Chainsawfelix/ELEC3117-BLUESAT/MAIN.kicad_pcb

## KiCad design MAIN.kicad_pcb (2026-08-09)

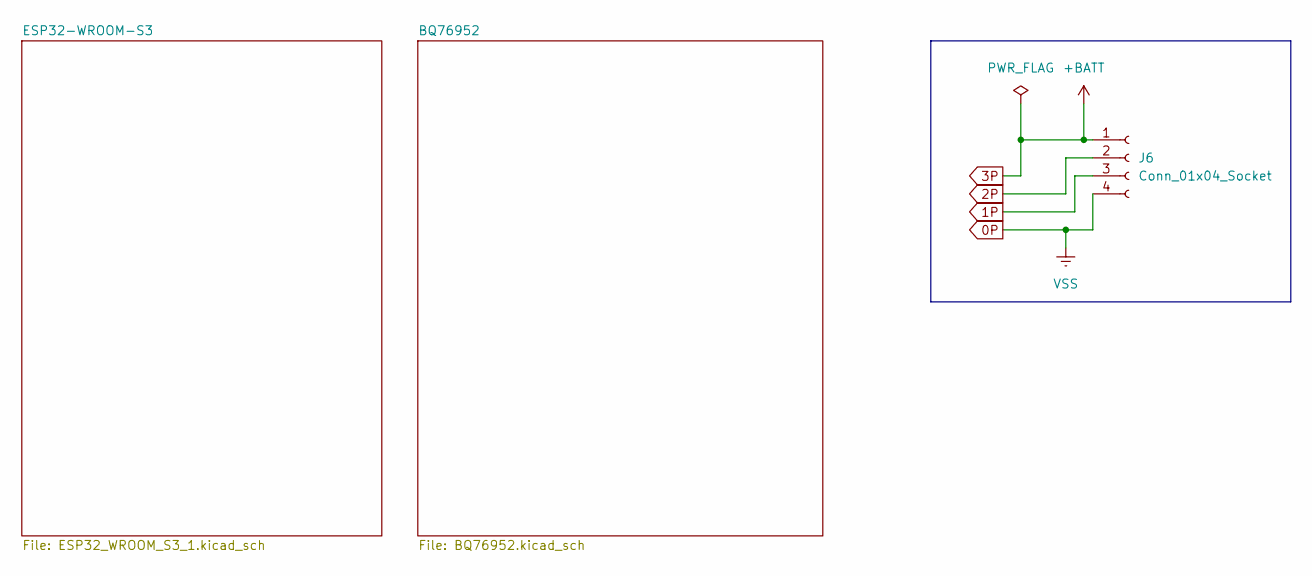
[picture p1: schematic MAIN.kicad_sch]

Parts:
J6: Conn_01x04_Socket; JST_XH_B4B-XH-A_1x04_P2.50mm_Vertical

Connections:
0P: J6.4; also elsewhere on the board
1P: J6.3; also elsewhere on the board
2P: J6.2; also elsewhere on the board

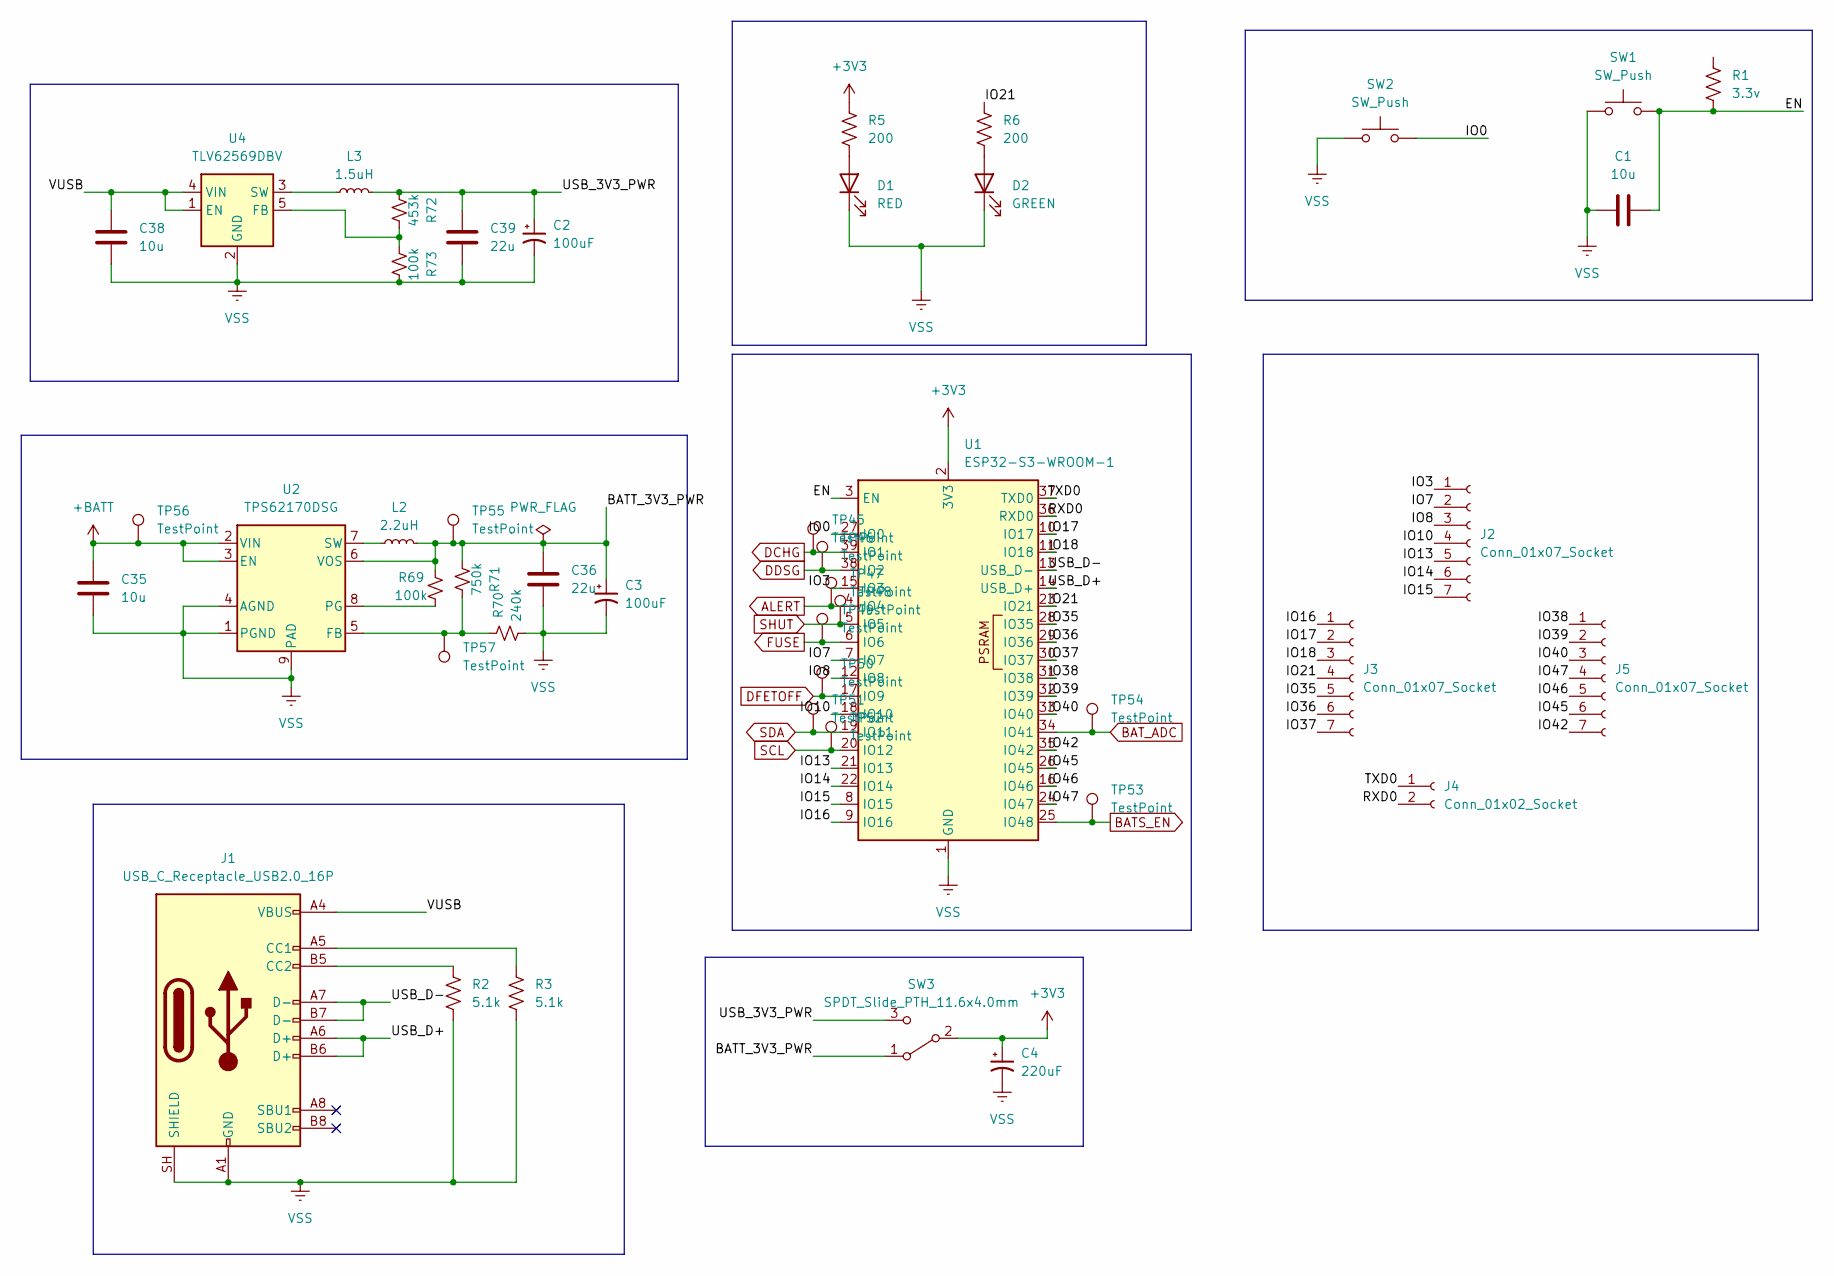
[picture p2: schematic ESP32_WROOM_S3_1.kicad_sch]

Parts:
C1, C35, C38: 10u; C_0805_2012Metric
C2, C3: 100uF; CP_Elec_6.3x5.8
C4: 220uF; CP_Elec_6.3x5.8
C36, C39: 22u; C_0805_2012Metric
D1: RED; LED_0805_2012Metric
D2: GREEN; LED_0805_2012Metric
J1: USB_C_Receptacle_USB2.0_16P; USB_C_Receptacle_GCT_USB4105-xx-A_16P_TopMnt_Horizontal
J2, J3, J5: Conn_01x07_Socket; JST_XH_B7B-XH-A_1x07_P2.50mm_Vertical
J4: Conn_01x02_Socket; JST_XH_B2B-XH-A_1x02_P2.50mm_Vertical
L2: 2.2uH; L_Wuerth_MAPI-3020
L3: 1.5uH; L_Wuerth_MAPI-3020
R1: 3.3v; R_0805_2012Metric
R2, R3: 5.1k; R_0805_2012Metric
R5, R6: 200; R_0805_2012Metric
R69, R73: 100k; R_0805_2012Metric
R70: 240k; R_0805_2012Metric
R71: 750k; R_0805_2012Metric
R72: 453k; R_0805_2012Metric
SW1, SW2: SW_Push; Push_SMD_4.2x3.2mm
SW3: SPDT_Slide_PTH_11.6x4.0mm; Slide_SPDT_PTH_11.6x4.0mm
TP45, TP46, TP47, TP48, TP49, TP50, TP51, TP52, TP53, TP54, TP55, TP56, TP57: TestPoint; TestPoint_Pad_D1.0mm
U1: ESP32-S3-WROOM-1
U2: TPS62170DSG; WSON-8-1EP_2x2mm_P0.5mm_EP0.9x1.6mm_ThermalVias
U4: TLV62569DBV; SOT-23-5

Connections:
0P: C1.1, C2.2, C3.2, C4.2, C35.2, C36.2, C38.2, C39.2, D1.1 (K), D2.1 (K), J1.A1 (GND), J1.A12 (GND), J1.B1 (GND), J1.B12 (GND), J1.SH (SHIELD), R2.2, R3.2, R70.2, R73.2, SW1.1, SW2.1, U1.1 (GND), U1.40 (GND), U1.41 (GND), U2.1 (PGND), U2.4 (AGND), U2.9 (PAD), U4.2 (GND); also elsewhere on the board
+3V3: C4.1, R5.1, SW3.2 (B), U1.2 (3V3); also elsewhere on the board
/ESP32-WROOM-S3/BATT_3V3_PWR: C3.1, C36.1, L2.2, R69.1, R71.1, SW3.1 (A), TP55.1 (1_1), U2.6 (VOS)
/ESP32-WROOM-S3/IO0: SW2.2, U1.27 (IO0)
/ESP32-WROOM-S3/IO3: J2.1, U1.15 (IO3)
/ESP32-WROOM-S3/IO7: J2.2, U1.7 (IO7)
/ESP32-WROOM-S3/IO8: J2.3, U1.12 (IO8)
/ESP32-WROOM-S3/IO10: J2.4, U1.18 (IO10)
/ESP32-WROOM-S3/IO13: J2.5, U1.21 (IO13)
/ESP32-WROOM-S3/IO14: J2.6, U1.22 (IO14)
/ESP32-WROOM-S3/IO15: J2.7, U1.8 (IO15)
/ESP32-WROOM-S3/IO16: J3.1, U1.9 (IO16)
/ESP32-WROOM-S3/IO17: J3.2, U1.10 (IO17)
/ESP32-WROOM-S3/IO18: J3.3, U1.11 (IO18)
/ESP32-WROOM-S3/IO21: J3.4, R6.1, U1.23 (IO21)
/ESP32-WROOM-S3/IO35: J3.5, U1.28 (IO35)
/ESP32-WROOM-S3/IO36: J3.6, U1.29 (IO36)
/ESP32-WROOM-S3/IO37: J3.7, U1.30 (IO37)
/ESP32-WROOM-S3/IO38: J5.1, U1.31 (IO38)
/ESP32-WROOM-S3/IO39: J5.2, U1.32 (IO39)
/ESP32-WROOM-S3/IO40: J5.3, U1.33 (IO40)
/ESP32-WROOM-S3/IO42: J5.7, U1.35 (IO42)
/ESP32-WROOM-S3/IO45: J5.6, U1.26 (IO45)
/ESP32-WROOM-S3/IO46: J5.5, U1.16 (IO46)
/ESP32-WROOM-S3/IO47: J5.4, U1.24 (IO47)
/ESP32-WROOM-S3/RXD0: J4.2, U1.36 (RXD0)
/ESP32-WROOM-S3/TXD0: J4.1, U1.37 (TXD0)
/ESP32-WROOM-S3/USB_3V3_PWR: C2.1, C39.1, L3.2, R72.1, SW3.3 (C)
/ESP32-WROOM-S3/USB_D+: J1.A6 (D+), J1.B6 (D+), U1.14 (USB_D+)
/ESP32-WROOM-S3/USB_D-: J1.A7 (D-), J1.B7 (D-), U1.13 (USB_D-)
/ESP32-WROOM-S3/VUSB: C38.1, J1.A4 (VBUS), J1.A9 (VBUS), J1.B4 (VBUS), J1.B9 (VBUS), U4.1 (EN), U4.4 (VIN)
ALERT: TP47.1, U1.4 (IO4); also elsewhere on the board
BATS_EN: TP53.1 (1_1), U1.25 (IO48); also elsewhere on the board
BAT_ADC: TP54.1 (1_1), U1.34 (IO41); also elsewhere on the board
DCHG: TP45.1, U1.39 (IO1); also elsewhere on the board
DDSG: TP46.1, U1.38 (IO2); also elsewhere on the board
DFETOFF: TP50.1, U1.17 (IO9); also elsewhere on the board
FUSE: TP49.1 (1_1), U1.6 (IO6); also elsewhere on the board
unnamed: D1.2 (A), R5.2
unnamed: D2.2 (A), R6.2
unnamed: J1.A5 (CC1), R3.1
unnamed: J1.B5 (CC2), R2.1
unnamed: R70.1, R71.2, TP57.1 (1_1), U2.5 (FB)
unnamed: R69.2, U2.8 (PG)
unnamed: L2.1, U2.7 (SW)
unnamed: R72.2, R73.1, U4.5 (FB)
unnamed: L3.1, U4.3 (SW)
SCL: TP52.1, U1.20 (IO12); also elsewhere on the board
SDA: TP51.1 (1_1), U1.19 (IO11); also elsewhere on the board
SHUT: TP48.1 (1_1), U1.5 (IO5); also elsewhere on the board

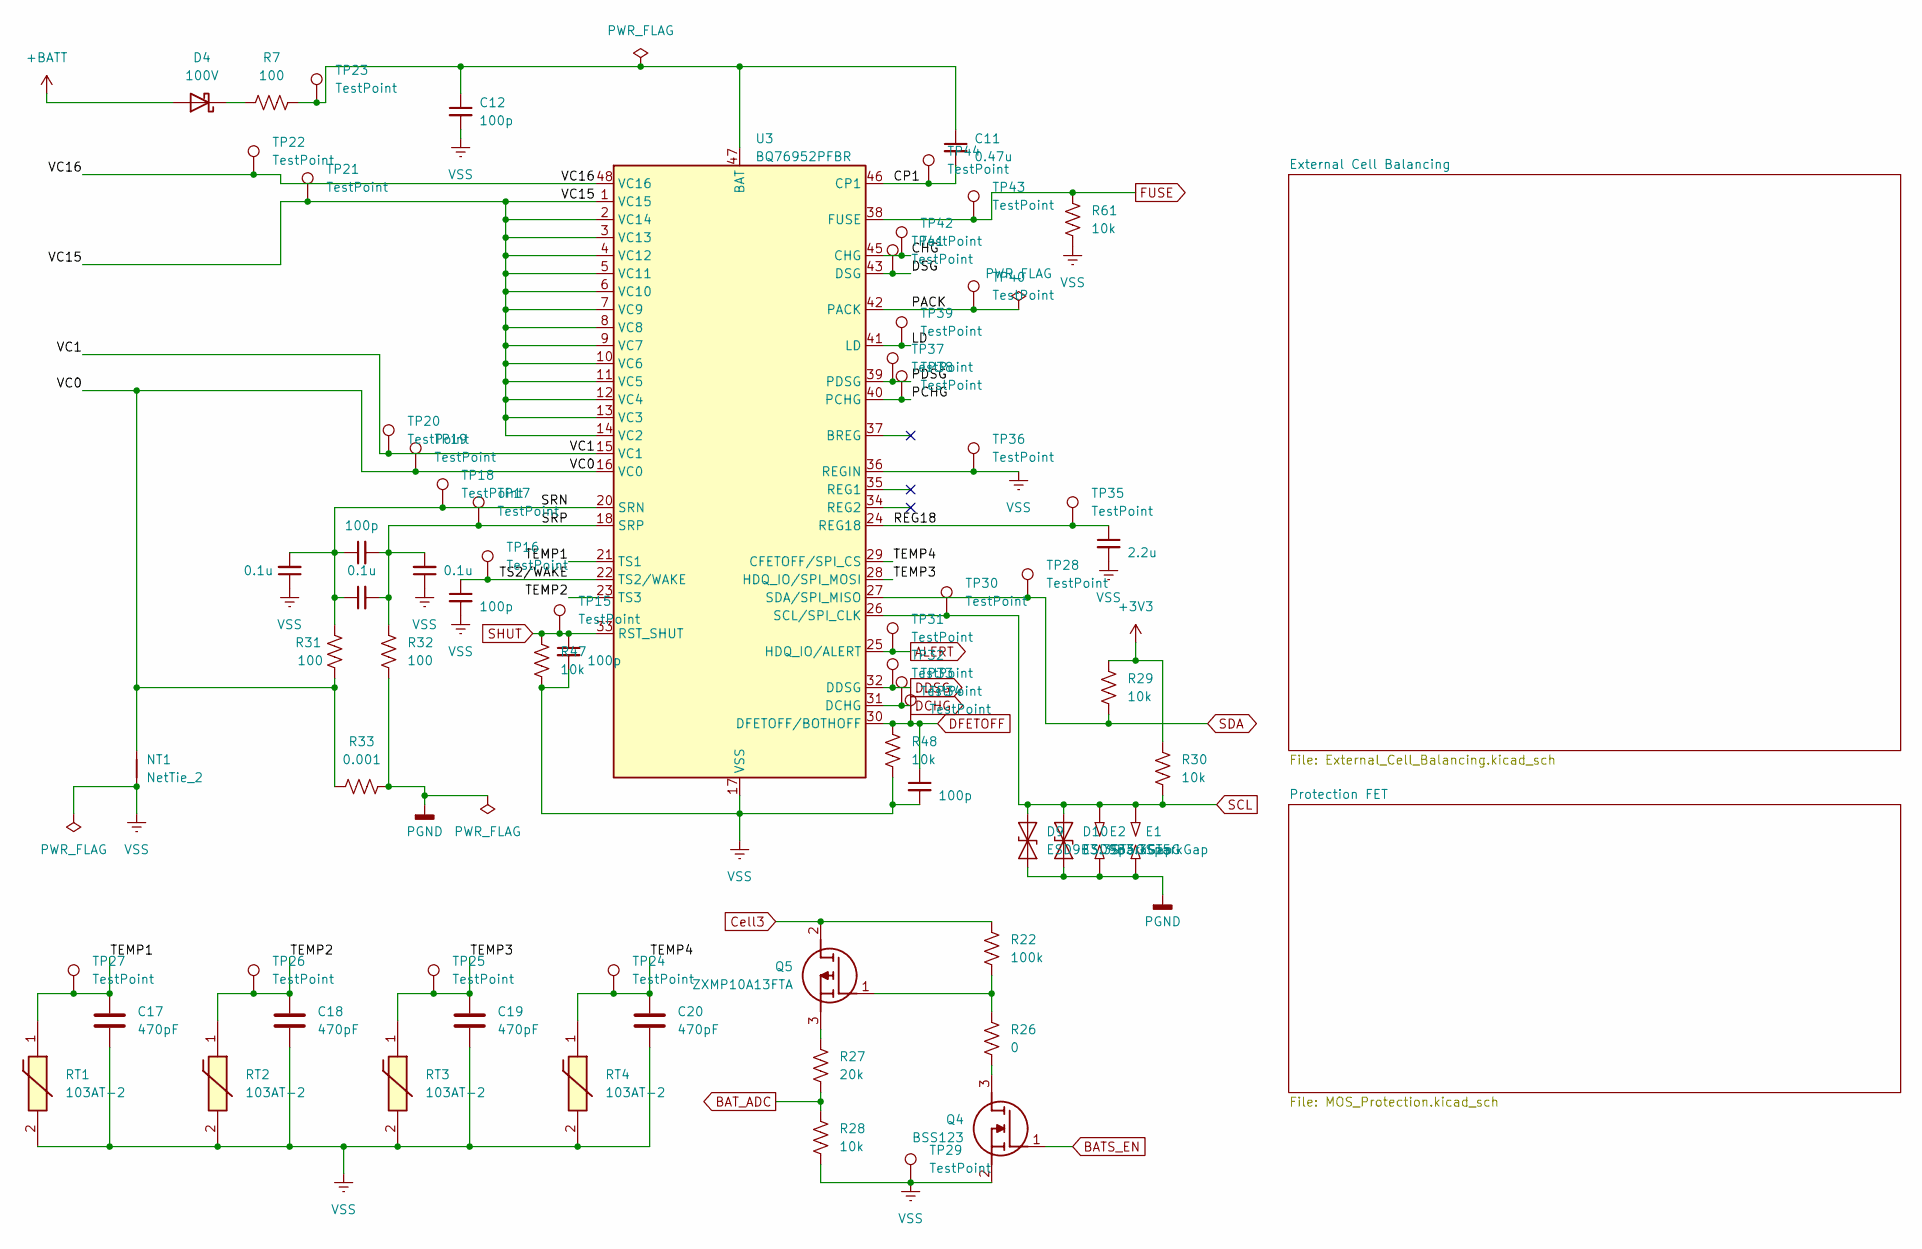
[picture p3: schematic BQ76952.kicad_sch]

Parts:
C11: 0.47u; C_0805_2012Metric
C12, C22, C30, C31, C32: 100p; C_0805_2012Metric
C17, C18, C19, C20: 470pF; C_0805_2012Metric
C21: 2.2u; C_0805_2012Metric
C23, C24, C25: 0.1u; C_0805_2012Metric
D4: 100V; D_0805_2012Metric
D9, D10: ESD9B3.3ST5G; D_SOD-923
E1, E2: SparkGap; SolderJumper-2_P1.3mm_Open_TrianglePad1.0x1.5mm
NT1: NetTie_2; SolderJumper-2_P1.3mm_Bridged2Bar_Pad1.0x1.5mm
Q4: BSS123; SOT96P237X111-3N; Mouser Part Number 512-BSS123
Q5: ZXMP10A13FTA; SOT96P240X110-3N; Mouser Part Number 522-ZXMP10A13FTA
R7, R31, R32: 100; R_0805_2012Metric
R22: 100k; R_0805_2012Metric
R26: 0; R_0805_2012Metric
R27: 20k; R_0805_2012Metric
R28, R29, R30, R47, R48, R61: 10k; R_0805_2012Metric
R33: 0.001; R_2512_6332Metric
RT1, RT2, RT3, RT4: 103AT-2; 103AT2; Mouser Part Number 954-103AT-2
TP15, TP16, TP17, TP18, TP19, TP20, TP21, TP22, TP23, TP24, TP25, TP26, TP27, TP28, TP29, TP30, TP31, TP32, TP33, TP34, TP35, TP36, TP37, TP38, TP39, TP40, TP41, TP42, TP43, TP44: TestPoint; TestPoint_Pad_D1.0mm
U3: BQ76952PFBR; TQFP-48_7x7mm_P0.5mm

Connections:
0P: C12.2, C17.2, C18.2, C19.2, C20.2, C21.2, C24.1, C25.1, C30.2, C31.2, C32.2, NT1.1, Q4.2 (S), R28.2, R47.2, R48.2, R61.2, RT1.2, RT2.2, RT3.2, RT4.2, TP29.1 (1_1), TP36.1 (1_1), U3.17 (VSS), U3.36 (REGIN); also elsewhere on the board
+3V3: R29.1, R30.1; also elsewhere on the board
/BQ76952/CHG: TP42.1 (1_1), U3.45 (CHG)
/BQ76952/CP1: C11.2, TP44.1 (1_1), U3.46 (CP1)
/BQ76952/DSG: TP41.1 (1_1), U3.43 (DSG)
/BQ76952/LD: TP39.1 (1_1), U3.41 (LD)
/BQ76952/PACK: TP40.1 (1_1), U3.42 (PACK)
/BQ76952/PCHG: TP38.1 (1_1), U3.40 (PCHG)
/BQ76952/PDSG: TP37.1 (1_1), U3.39 (PDSG)
/BQ76952/REG18: C21.1, TP35.1 (1_1), U3.24 (REG18)
/BQ76952/SRN: C22.1, C23.1, C24.2, R31.1, TP18.1 (1_1), U3.20 (SRN)
/BQ76952/SRP: C22.2, C23.2, C25.2, R32.1, TP17.1 (1_1), U3.18 (SRP)
/BQ76952/TEMP1: C17.1, RT1.1, TP27.1 (1_1), U3.21 (TS1)
/BQ76952/TEMP2: C18.1, RT2.1, TP26.1 (1_1), U3.23 (TS3)
/BQ76952/TEMP3: C19.1, RT3.1, TP25.1 (1_1), U3.28 (HDQ_IO/SPI_MOSI)
/BQ76952/TEMP4: C20.1, RT4.1, TP24.1 (1_1), U3.29 (CFETOFF/SPI_CS)
/BQ76952/TS2/WAKE: C30.1, TP16.1 (1_1), U3.22 (TS2/WAKE)
/BQ76952/VC0: NT1.2, R31.2, R33.1, TP19.1 (1_1), U3.16 (VC0); also elsewhere on the board
/BQ76952/VC1: TP20.1 (1_1), U3.15 (VC1); also elsewhere on the board
/BQ76952/VC15: TP21.1 (1_1), U3.1 (VC15), U3.2 (VC14), U3.3 (VC13), U3.4 (VC12), U3.5 (VC11), U3.6 (VC10), U3.7 (VC9), U3.8 (VC8), U3.9 (VC7), U3.10 (VC6), U3.11 (VC5), U3.12 (VC4), U3.13 (VC3), U3.14 (VC2); also elsewhere on the board
ALERT: TP31.1 (1_1), U3.25 (HDQ_IO/ALERT); also elsewhere on the board
BATS_EN: Q4.1 (G); also elsewhere on the board
BAT_ADC: R27.2, R28.1; also elsewhere on the board
Cell3: Q5.2 (D), R22.1
DCHG: TP33.1 (1_1), U3.31 (DCHG); also elsewhere on the board
DDSG: TP32.1 (1_1), U3.32 (DDSG); also elsewhere on the board
DFETOFF: C32.1, R48.1, TP34.1 (1_1), U3.30 (DFETOFF/BOTHOFF); also elsewhere on the board
FUSE: R61.1, TP43.1 (1_1), U3.38 (FUSE); also elsewhere on the board
unnamed: D4.1 (K), R7.1
unnamed: Q4.3 (D), R26.2
unnamed: Q5.1 (G), R22.2, R26.1
unnamed: Q5.3 (S), R27.1
unnamed 109: C11.1, C12.1, R7.2, TP23.1 (1_1), U3.47 (BAT); also elsewhere on the board
PACK-: D9.1 (A1), D10.1 (A1), E1.1, E2.1, R32.2, R33.2; also elsewhere on the board
SCL: D9.2 (A2), D10.2 (A2), E1.2, E2.2, R30.2, TP30.1 (1_1), U3.26 (SCL/SPI_CLK); also elsewhere on the board
SDA: R29.2, TP28.1 (1_1), U3.27 (SDA/SPI_MISO); also elsewhere on the board
SHUT: C31.1, R47.1, TP15.1 (1_1), U3.33 (RST_SHUT); also elsewhere on the board

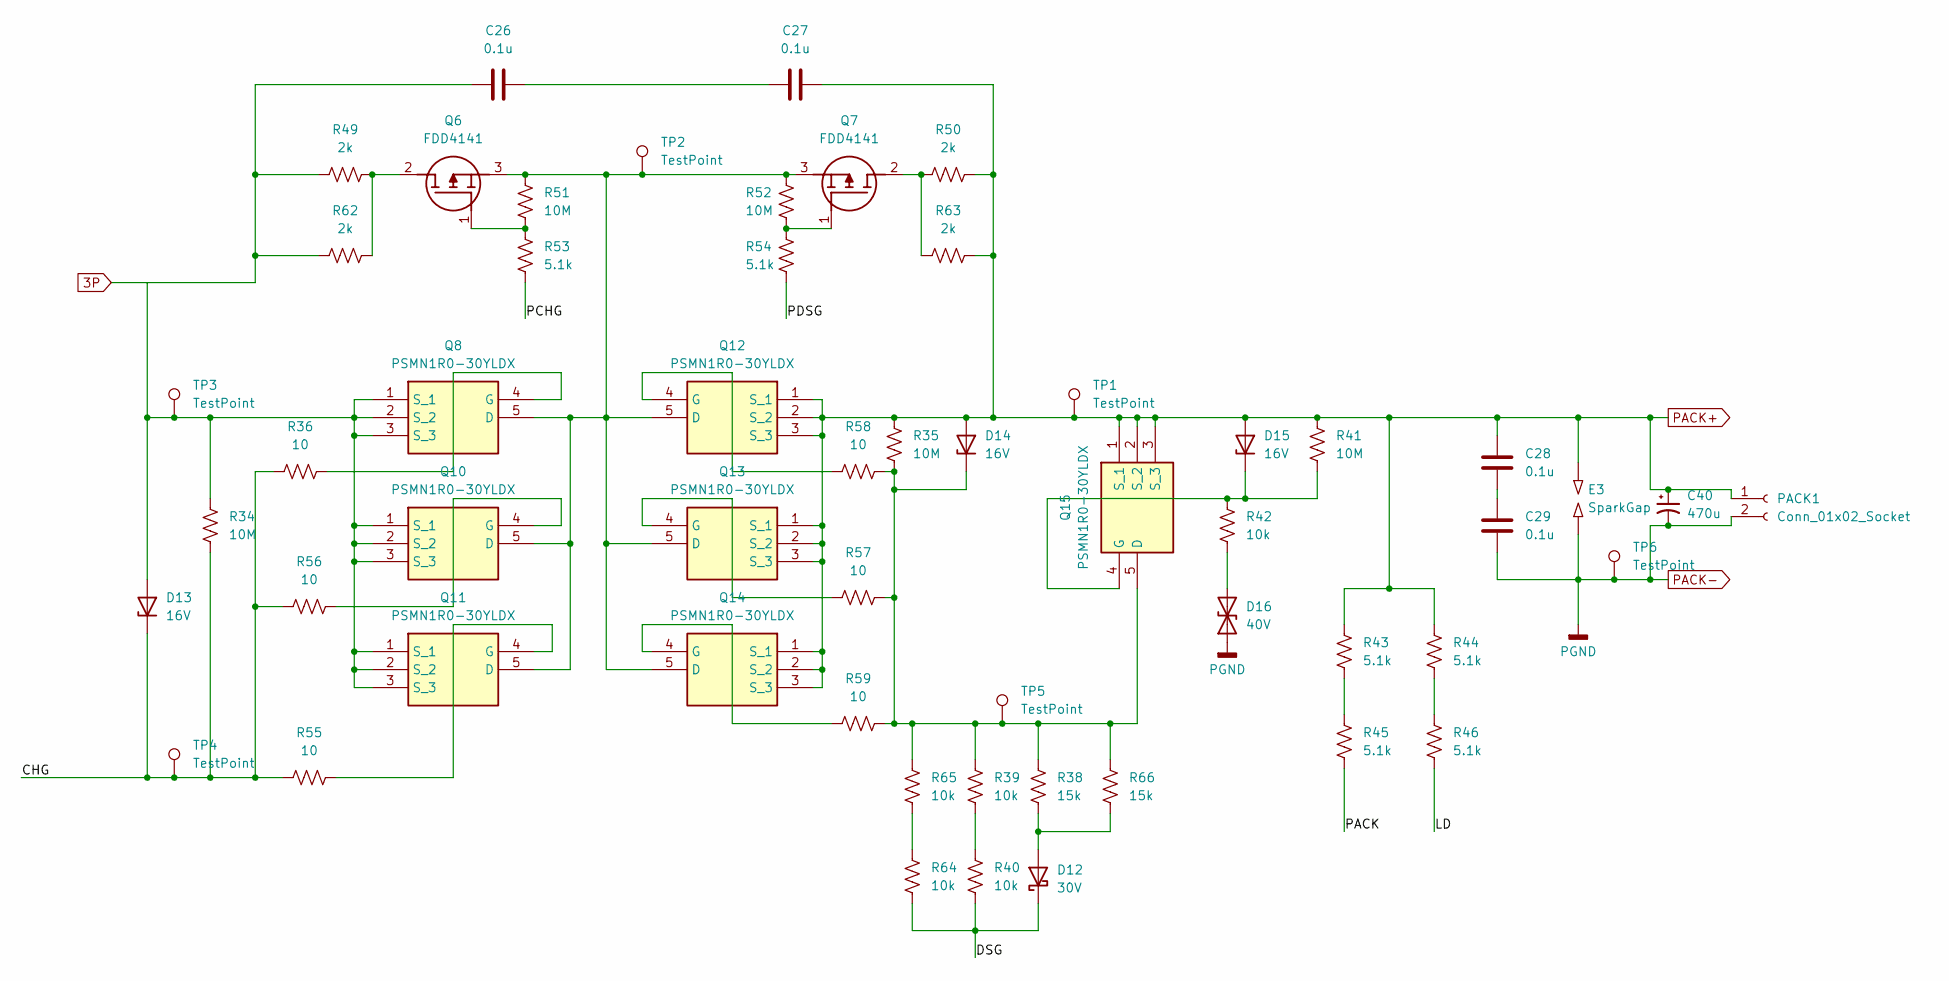
[picture p4: schematic MOS_Protection.kicad_sch]

Parts:
C26, C27, C28, C29: 0.1u; C_0805_2012Metric
C40: 470u; C_Elec_8x10.2
D12: 30V; D_SOD-123
D13, D14, D15: 16V; D_SOD-123
D16: 40V; D_SOD-123
E3: SparkGap; SolderJumper-2_P1.3mm_Open_TrianglePad1.0x1.5mm
PACK1: Conn_01x02_Socket; AMASS_XT60-F_1x02_P7.20mm_Vertical
Q6, Q7: FDD4141; FQD1N80TM; Mouser Part Number 512-FDD4141
Q8, Q10, Q11, Q12, Q13, Q14, Q15: PSMN1R0-30YLDX; PSMN5R660YLX; Mouser Part Number 771-PSMN1R0-30YLDX
R34, R35, R41, R51, R52: 10M; R_0805_2012Metric
R36, R55, R56, R57, R58, R59: 10; R_0805_2012Metric
R38, R66: 15k; R_0805_2012Metric
R39, R40, R42, R64, R65: 10k; R_0805_2012Metric
R43, R44, R45, R46, R53, R54: 5.1k; R_0805_2012Metric
R49, R50, R62, R63: 2k; R_0805_2012Metric
TP1, TP2, TP3, TP4, TP5, TP6: TestPoint; TestPoint_Pad_D1.0mm

Connections:
/BQ76952/Protection FET/CHG: D13.1 (K), R34.2, R36.1, R55.1, R56.1, TP4.1
/BQ76952/Protection FET/DSG: D12.1 (K), R40.2, R64.2
/BQ76952/Protection FET/LD: R46.2
/BQ76952/Protection FET/PACK: R45.2
/BQ76952/Protection FET/PCHG: R53.1
/BQ76952/Protection FET/PDSG: R54.1
unnamed: C26.2, C27.1
unnamed: C28.1, C29.2
unnamed: D12.2 (A), R38.2, R66.2
unnamed: D13.2 (A), Q8.1 (S_1), Q8.2 (S_2), Q8.3 (S_3), Q10.1 (S_1), Q10.2 (S_2), Q10.3 (S_3), Q11.1 (S_1), Q11.2 (S_2), Q11.3 (S_3), R34.1, TP3.1
unnamed: D14.1 (K), Q15.5 (D), Q15.6, R35.2, R38.1, R39.1, R57.2, R58.2, R59.2, R65.1, R66.1, TP5.1 (1_1)
unnamed: D15.1 (K), Q15.4 (G), R41.2, R42.1
unnamed: D16.2 (A2), R42.2
unnamed: Q6.2 (D), R49.2, R62.2
unnamed: Q6.1 (G), R51.1, R53.2
unnamed: Q7.2 (D), R50.1, R63.1
unnamed: Q7.1 (G), R52.1, R54.2
unnamed: Q8.4 (G), R36.2
unnamed: Q6.3 (S), Q7.3 (S), Q8.5 (D), Q8.6, Q10.5 (D), Q10.6, Q11.5 (D), Q11.6, Q12.5 (D), Q12.6, Q13.5 (D), Q13.6, Q14.5 (D), Q14.6, R51.2, R52.2, TP2.1 (1_1)
unnamed: Q10.4 (G), R56.2
unnamed: Q11.4 (G), R55.2
unnamed: Q12.4 (G), R58.1
unnamed: Q13.4 (G), R57.1
unnamed: Q14.4 (G), R59.1
unnamed: R39.2, R40.1
unnamed: R43.2, R45.1
unnamed: R44.2, R46.1
unnamed: R64.1, R65.2
PACK+: C27.2, C28.2, C40.1, D14.2 (A), D15.2 (A), E3.2, PACK1.1, Q12.1 (S_1), Q12.2 (S_2), Q12.3 (S_3), Q13.1 (S_1), Q13.2 (S_2), Q13.3 (S_3), Q14.1 (S_1), Q14.2 (S_2), Q14.3 (S_3), Q15.1 (S_1), Q15.2 (S_2), Q15.3 (S_3), R35.1, R41.1, R43.1, R44.1, R50.2, R63.2, TP1.1
PACK-: C29.1, C40.2, D16.1 (A1), E3.1, PACK1.2, TP6.1; also elsewhere on the board

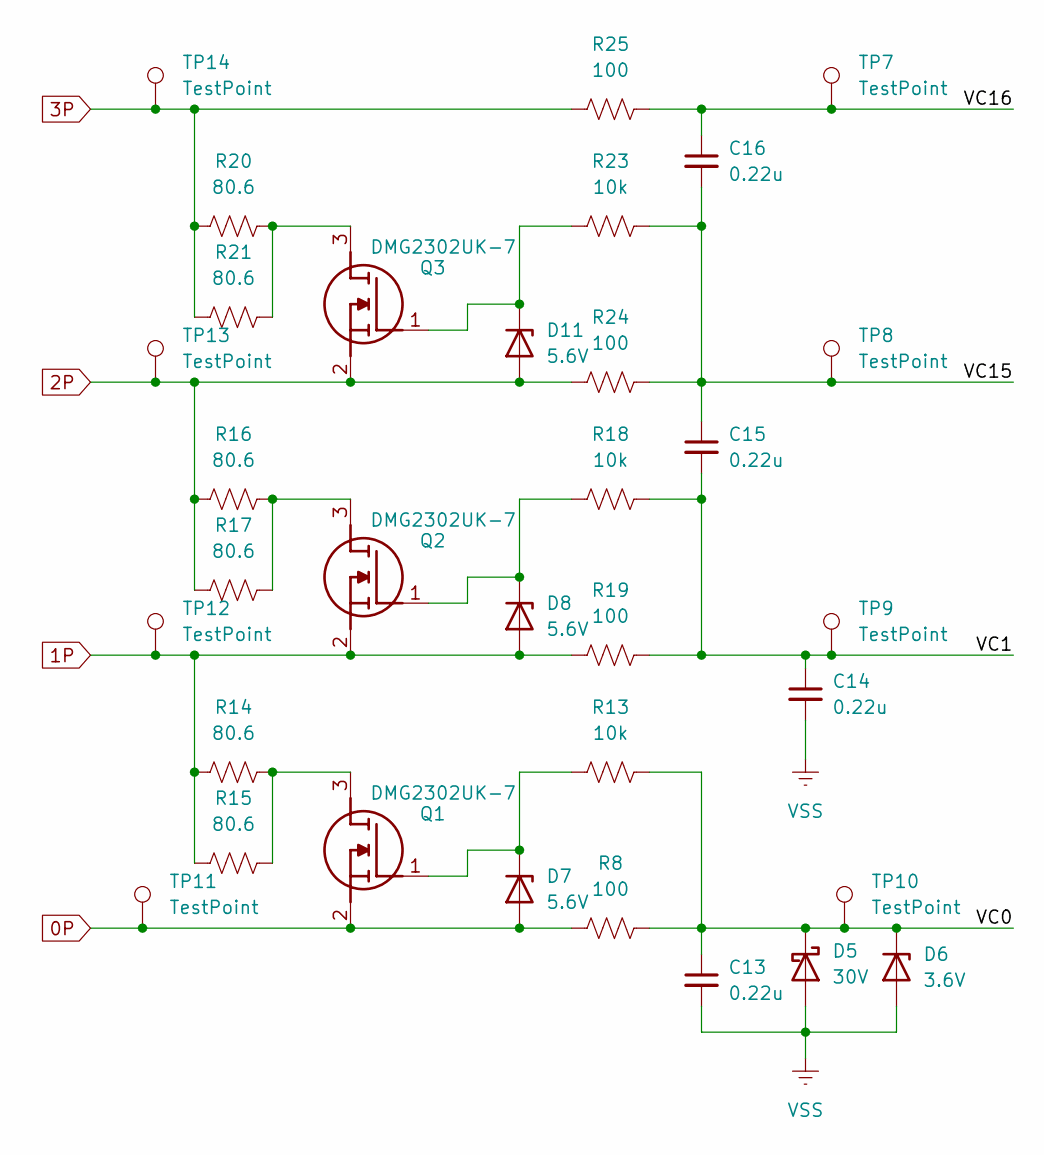
[picture p5: schematic External_Cell_Balancing.kicad_sch]

Parts:
C13, C14, C15, C16: 0.22u; C_0805_2012Metric
D5: 30V; D_SOD-123
D6: 3.6V; D_SOD-123
D7, D8, D11: 5.6V; D_SOD-123
Q1, Q2, Q3: DMG2302UK-7; SOT96P240X110-3N; Mouser Part Number 621-DMG2302UK-7
R8, R19, R24, R25: 100; R_0805_2012Metric
R13, R18, R23: 10k; R_0805_2012Metric
R14, R15, R16, R17, R20, R21: 80.6; R_0805_2012Metric
TP7, TP8, TP9, TP10, TP11, TP12, TP13, TP14: TestPoint; TestPoint_Pad_D1.0mm

Connections:
0P: C13.2, C14.2, D5.2 (A), D6.2 (A), D7.2 (A), Q1.2 (S), R8.2, TP11.1 (1_1); also elsewhere on the board
1P: D8.2 (A), Q2.2 (S), R14.1, R15.1, R19.2, TP12.1 (1_1); also elsewhere on the board
2P: D11.2 (A), Q3.2 (S), R16.1, R17.1, R24.2, TP13.1 (1_1); also elsewhere on the board
/BQ76952/External Cell Balancing/VC0: C13.1, D5.1 (K), D6.1 (K), R8.1, R13.1, TP10.1 (1_1)
/BQ76952/External Cell Balancing/VC1: C14.1, C15.2, R18.1, R19.1, TP9.1 (1_1)
/BQ76952/External Cell Balancing/VC15: C15.1, C16.2, R23.1, R24.1, TP8.1 (1_1)
/BQ76952/External Cell Balancing/VC16: C16.1, R25.1, TP7.1 (1_1)
unnamed: D7.1 (K), Q1.1 (G), R13.2
unnamed: D8.1 (K), Q2.1 (G), R18.2
unnamed: D11.1 (K), Q3.1 (G), R23.2
unnamed: Q1.3 (D), R14.2, R15.2
unnamed: Q2.3 (D), R16.2, R17.2
unnamed: Q3.3 (D), R20.2, R21.2

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
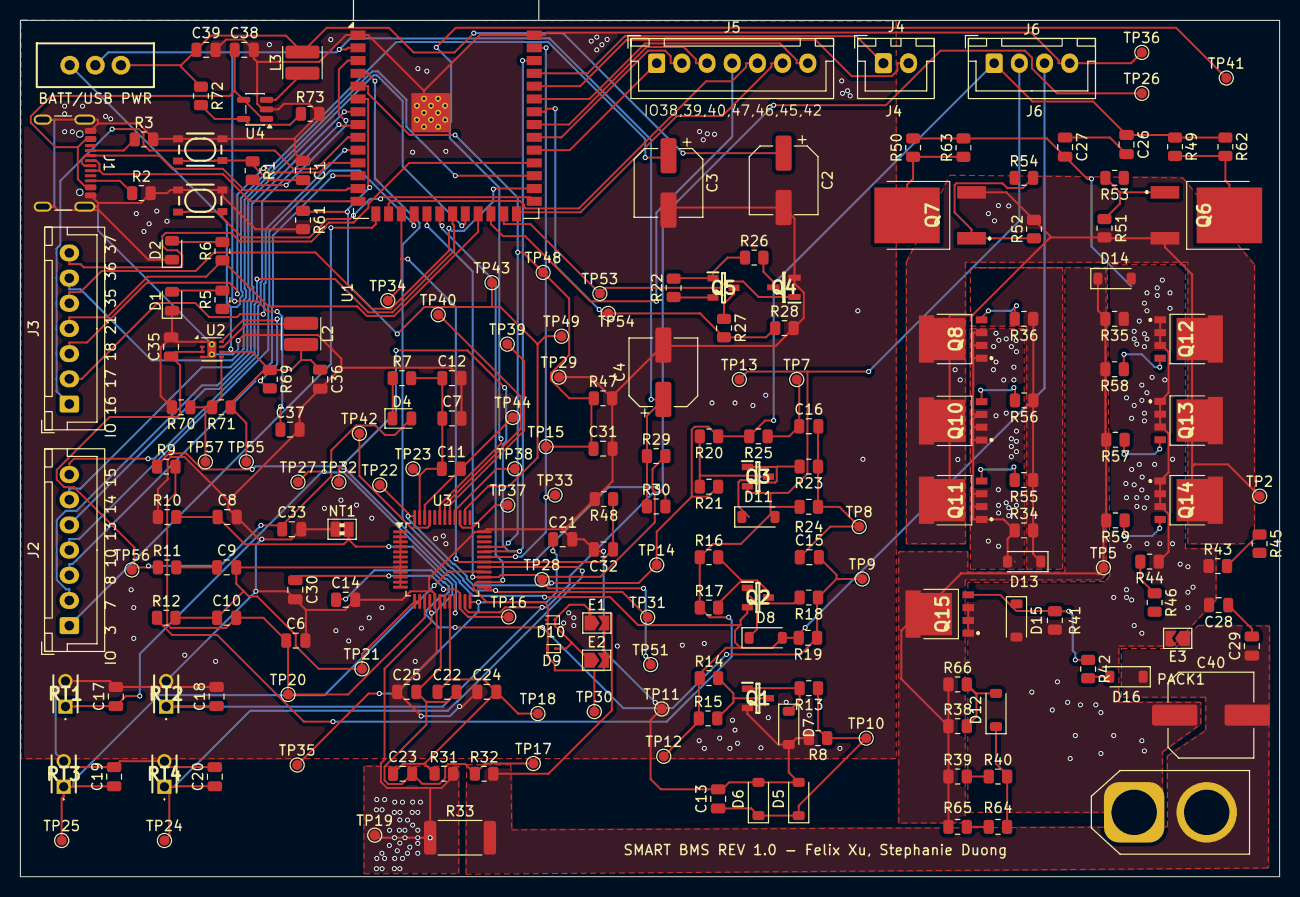
[picture p6: board MAIN.kicad_pcb from above]

Board: 2 copper layers, 125.0 x 85.0 mm, 207 parts (0 on the bottom side), 116 nets.

Other parts of the board:
C6, C8, C9, C10: 0.22u; C_0805_2012Metric
C7, C33: NC; C_0805_2012Metric
C37: 100u; C_0805_2012Metric
R9, R10, R11, R12: 20; R_0805_2012Metric

Their connections:
0P: C6.2, C7.2, C8.2, C33.2, C37.2, R10.1; also elsewhere on the board
1P: R9.1; also elsewhere on the board
2P: R12.1; also elsewhere on the board
+3V3: C37.1; also elsewhere on the board
/BQ76952/VC0: C8.1, R10.2; also elsewhere on the board
/BQ76952/VC1: C6.1, C10.2, R9.2; also elsewhere on the board
/BQ76952/VC15: C9.2, C10.1, R12.2; also elsewhere on the board
/BQ76952/VC16: C9.1, R11.2
unnamed 109: C7.1; also elsewhere on the board
