Chainsawfelix/ELEC3117-BLUESAT/(commit log)

2026-06-27 Add files via upload
    LAB2 PSU design files for Kicad for future PCB design reference
    [LAB_2_POWERSUPPLY_DESIGN.kicad_pcb, LAB_2_POWERSUPPLY_DESIGN.kicad_sch]
2026-06-27 Remove file from main (accidental merge)
    [LAB_2_POWERSUPPLY_DESIGN.kicad_pcb, LAB_2_POWERSUPPLY_DESIGN.kicad_sch]
2026-06-30 Add files via upload
    Added esp32-s3 schematic and also BQ76952
    [3S_LiPo.kicad_sch, BQ76952.kicad_sch, ESP32_WROOM_S3_1.kicad_sch, MAIN.kicad_pcb, MAIN.kicad_sch]
2026-07-06 Add files via upload
    Updated BQ76952 schematic with passive cell balancing, voltage readout to ESP32 and temperature sensing. To do: Connect remaining pins on BQ76952 to ESP32.
    [BQ76952.kicad_sch, ESP32_WROOM_S3_1.kicad_sch, MAIN.kicad_sch]
2026-07-09 Add files via upload
    Finalized BQ76952 Schematic with MOS Protection circuit. Need to add connections from chip to ESP32. Then implement PCB.
    [BQ76952.kicad_sch, MOS_Protection.kicad_sch, untitled.kicad_sch]
2026-07-15 REV1 PCB that was sent to production (PCBWAY)
    [3S_LiPo.kicad_sch, BQ76952.kicad_sch, ESP32_WROOM_S3_1.kicad_sch, External_Cell_Balancing.kicad_sch, MAIN.kicad_pcb, MAIN.kicad_sch, MOS_Protection.kicad_sch, untitled.kicad_sch]
2026-08-09 These files are for the final report
    NOTE:
    1. PCB has mixed up nets so many traces going to the BQ76952 are DISCONNECTED.
    2. BOTH active and passive balancing are connected in parallel even though only active balancing is supposed to be connected.
    [BQ76952.kicad_sch, ESP32_WROOM_S3_1.kicad_sch, MAIN.kicad_pcb]
